Makertech3D/AXIS/README.md

# AXIS
Files and downloadable content relating to the Axis 3D Printer.

Build manuals can be found [here.](https://makertech-3d.dozuki.com/c/AXIS_3D_Printer)
