Makertech3D/AXIS/Linear Rail Upgrade/README.md

# AXIS Linear Rail Upgrade

The Linear Rail Upgrade is unfortunately no longer available for sale. However you can self source the components for one with the BOM and STL. files (for the 3D printed parts) in this repo.

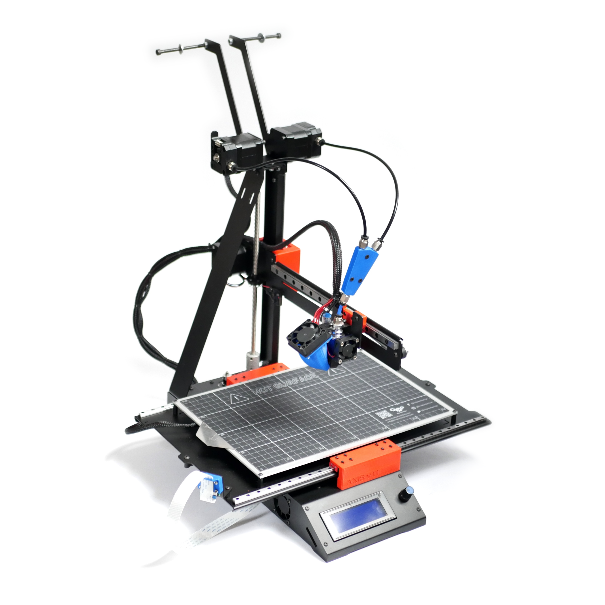
[picture p1: Linear Rail Upgrade/LRU Image.png]
