Makertech3D/AXIS/Linear Rail Upgrade/LRU BOM.xlsx

Part | Notes | Qty
MGN7 Rail - 400mm |  | 2
MGN7-H Block |  | 4
MGN9 Rail - 270mm |  | 1
MGN-9 Block |  | 1
MGN15 Rail - 270mm |  | 1
MGN-H Block |  | 1
Metal Coupling 5mmx8mm |  | 1
M4 Threaded Insert |  | 11
3D Printed Parts | https://github.com/Makertech3D/AXIS/tree/master/Linear%20Rail%20Upgrade
Fastener Pack
M2 x 10mm Cap | Rails to base | 6
M2 Nyloc Nut | Rails to base | 6
M2 x 6mm Cap | Base rails to bracket | 16
M3 x 12mm Cap | Rail to gantry and pillar | 6
M3 Nyloc Nut | Rail to gantry and pillar | 6
M3 x 6mm Button | Tool carraige to rail | 4
M3 x 8mm Cap | Gantry to Z-carriage | 4
M3 x 35mm Slot | Tool carraige belt hooks | 2
M4 x 6mm Button | Bracket mounting | 11
M3 x 15mm standoff | Heated Bed | 4
