Makertech3D/AXIS/Axis 3D Printed Parts/Axis Splitter v2_Back.STL

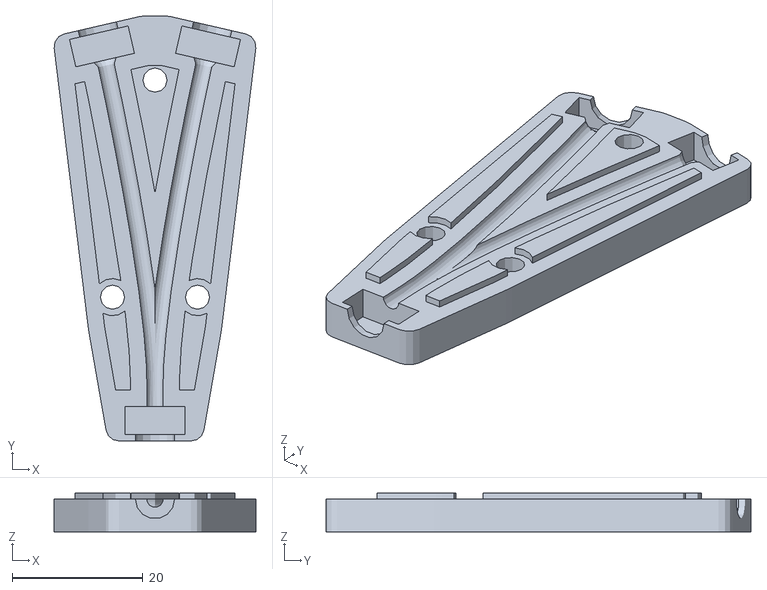
[picture p2: CAD file, 2020-10-02]
Axis 3D Printed Parts/Axis Splitter v2_Back.STL
30.8 x 65.0 x 5.90
