Makertech3D/AXIS/Axis Metal Parts/AXIS Base.STEP

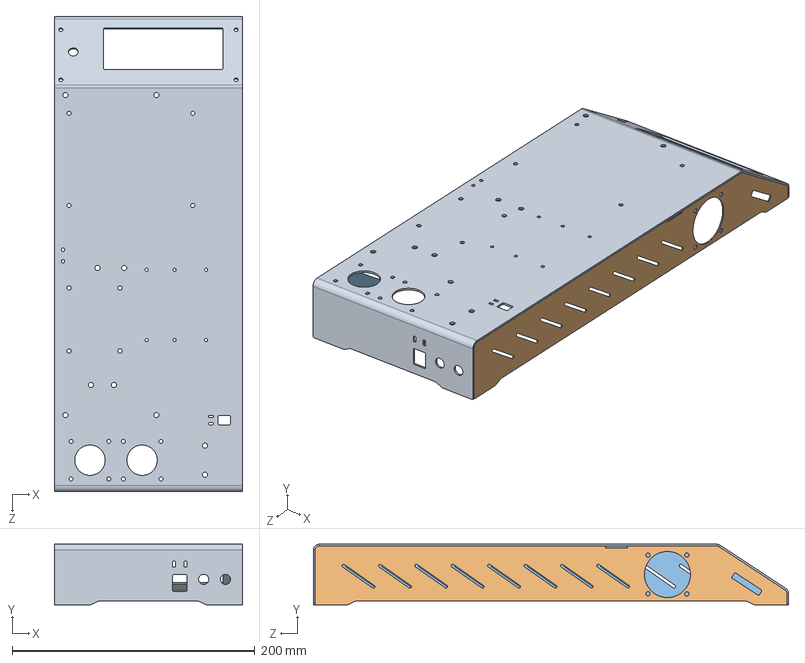
[picture p3: CAD file, 2020-06-16]
Axis Metal Parts/AXIS Base.STEP
155.0 x 50.0 x 392.0 mm
AXIS Base
AXIS Left Panel
AXIS Right Panel
