Makertech3D/AXIS/Linear Guides/Linear Guide Fixed.STEP

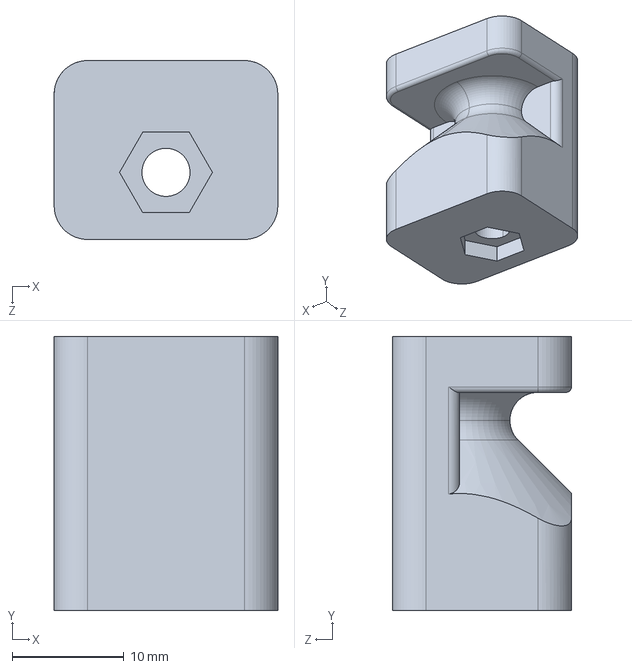
[picture p4: CAD file, 2020-08-13]
Linear Guides/Linear Guide Fixed.STEP
20.0 x 24.5 x 16.0 mm
