Makertech3D/AXIS/Linear Rail Upgrade/LRU_Z^AXIS v1.1.STL

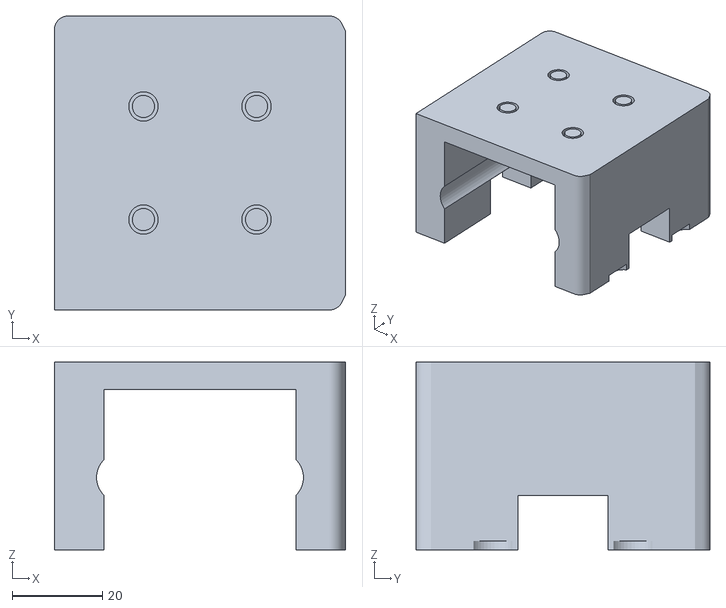
[picture p5: CAD file, 2022-01-27]
Linear Rail Upgrade/LRU_Z^AXIS v1.1.STL
64.4 x 65.0 x 41.5
