Makertech3D/AXIS/Axis Metal Parts/AXIS Z-Pillar_A.STEP

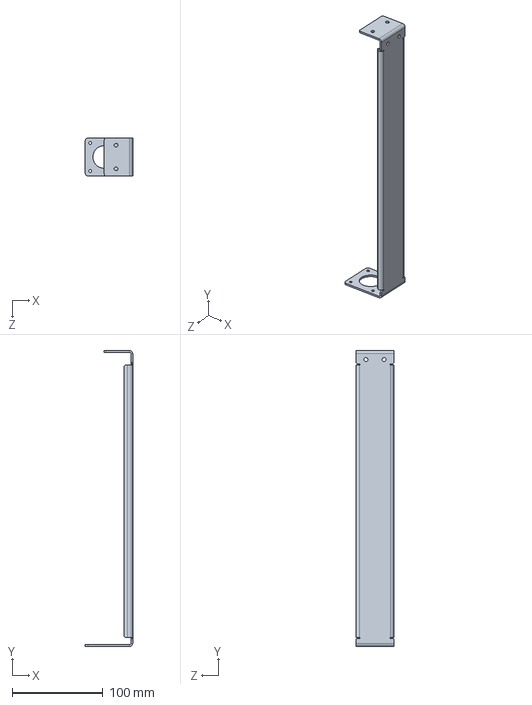
[picture p7: CAD file, 2020-06-16]
Axis Metal Parts/AXIS Z-Pillar_A.STEP
52.5 x 327.0 x 42.0 mm
