Makertech3D/AXIS/Linear Guides/Linear Guide Eccentric.STEP

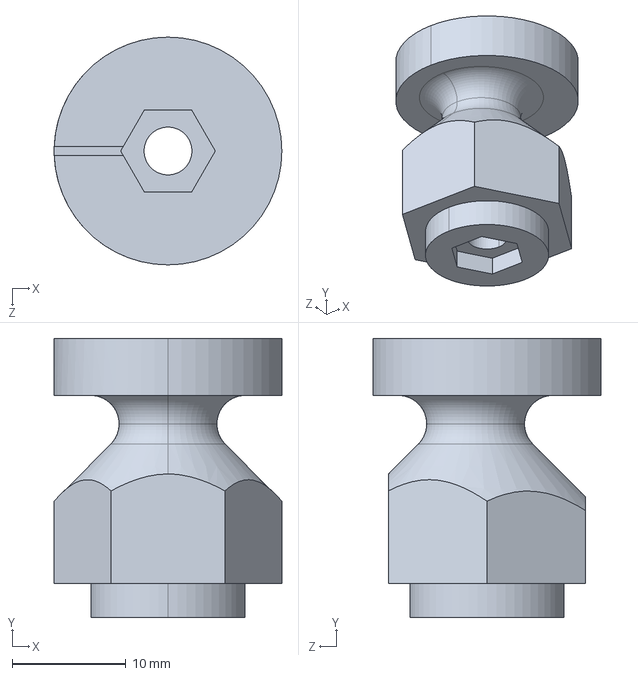
[picture p8: CAD file, 2020-08-13]
Linear Guides/Linear Guide Eccentric.STEP
20.0 x 24.5 x 20.0 mm
