Makertech3D/AXIS/Linear Rail Upgrade/LRU_Y^AXIS v1.1.STL

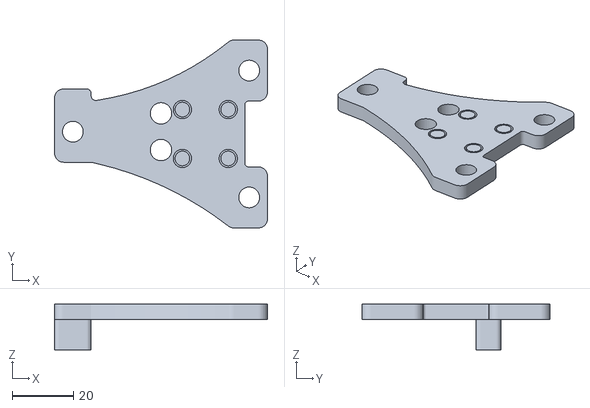
[picture p9: CAD file, 2022-01-27]
Linear Rail Upgrade/LRU_Y^AXIS v1.1.STL
69.7 x 61.5 x 15.0
