Makertech3D/AXIS/Axis 3D Printed Parts/Extruder motor holder (no spool).stl

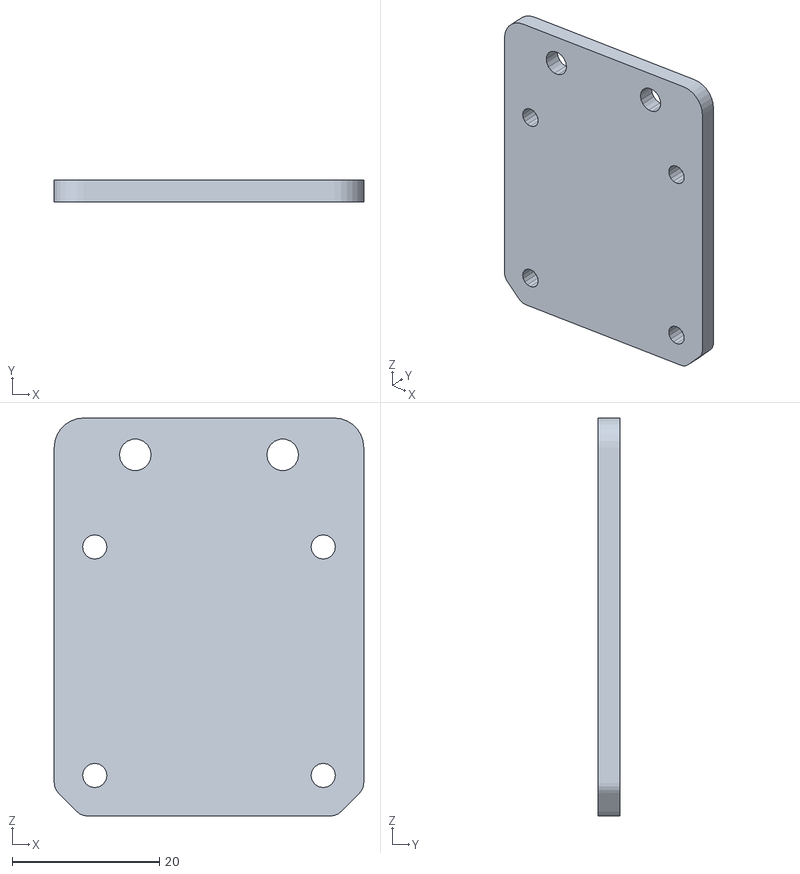
[picture p10: CAD file, 2020-08-17]
Axis 3D Printed Parts/Extruder motor holder (no spool).stl
42.0 x 3.00 x 54.0
