Makertech3D/AXIS/Linear Rail Upgrade/LRU_X-Rear^AXIS v1.1.STL

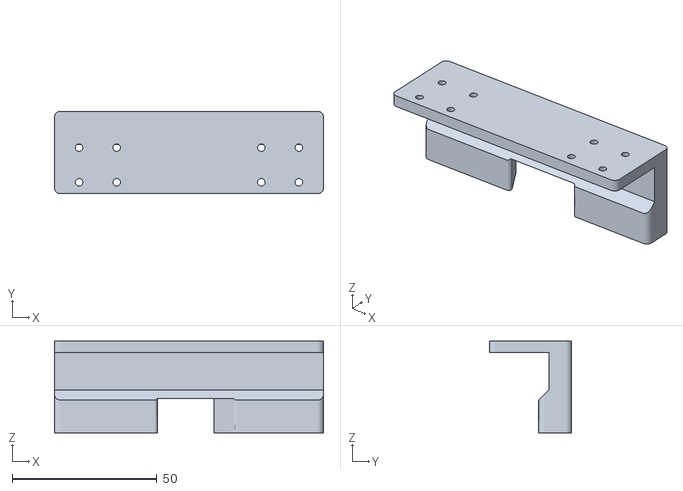
[picture p11: CAD file, 2022-01-27]
Linear Rail Upgrade/LRU_X-Rear^AXIS v1.1.STL
93.0 x 28.5 x 31.8
