Makertech3D/AXIS/Axis 3D Printed Parts/AXIS 40mm Fan Shroud.STL

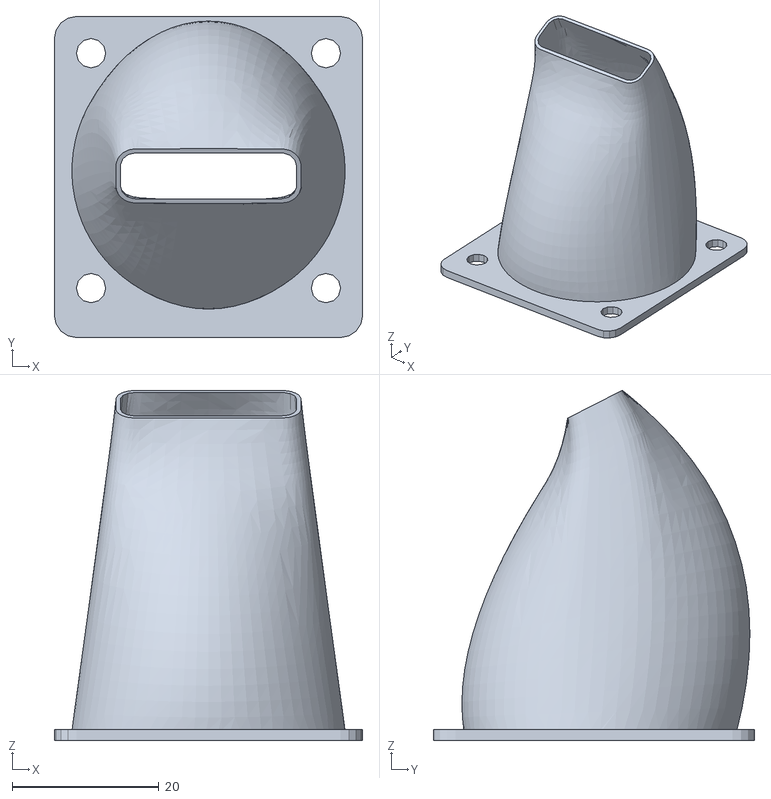
[picture p12: CAD file, 2020-08-03]
Axis 3D Printed Parts/AXIS 40mm Fan Shroud.STL
42.0 x 43.7 x 47.7
