Makertech3D/AXIS/Axis Metal Parts/AXIS Platform.STEP

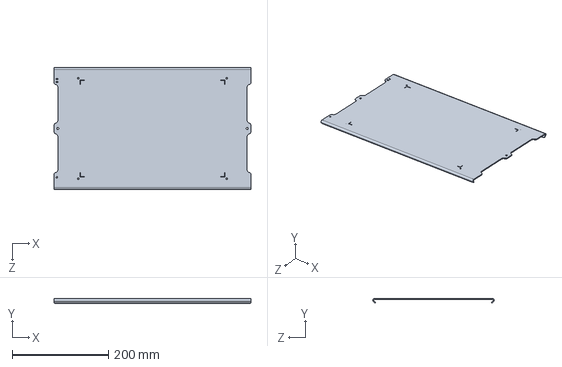
[picture p13: CAD file, 2020-06-16]
Axis Metal Parts/AXIS Platform.STEP
410.0 x 9.90 x 253.1 mm
