Makertech3D/AXIS/Linear Rail Upgrade/LRU_X-Front^AXIS v1.1.STL

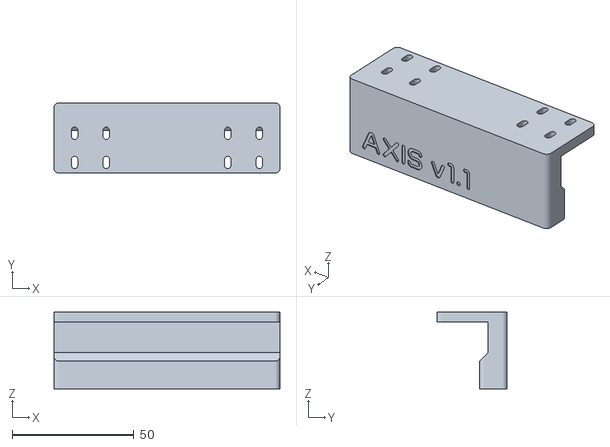
[picture p14: CAD file, 2022-01-27]
Linear Rail Upgrade/LRU_X-Front^AXIS v1.1.STL
93.0 x 29.0 x 31.5
