Makertech3D/AXIS/Axis 3D Printed Parts/Pi Cam 3D Printed Cover.STL

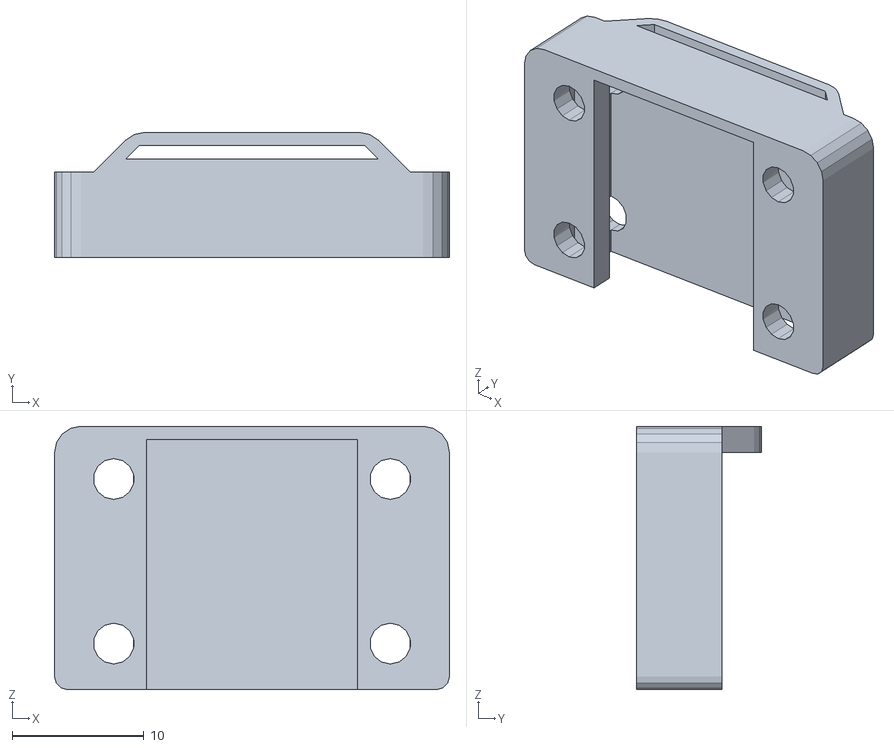
[picture p15: CAD file, 2020-08-03]
Axis 3D Printed Parts/Pi Cam 3D Printed Cover.STL
30.0 x 9.50 x 20.0
