Makertech3D/AXIS/Axis Metal Parts/AXIS Z-Pillar_B.STEP

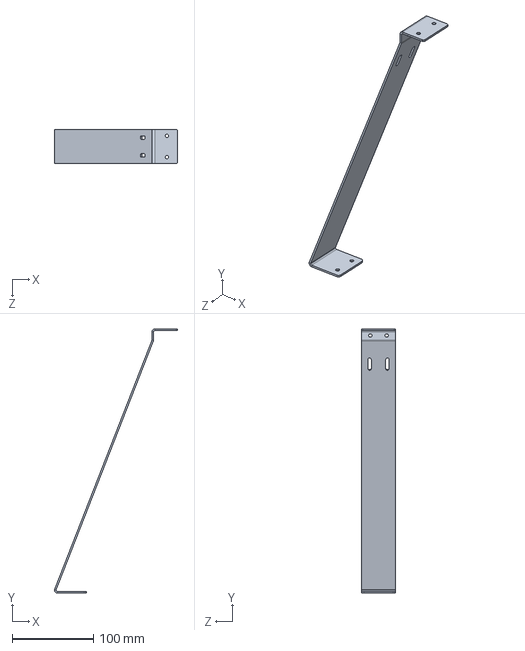
[picture p16: CAD file, 2020-06-16]
Axis Metal Parts/AXIS Z-Pillar_B.STEP
151.5 x 325.0 x 42.0 mm
