Makertech3D/AXIS/Axis Metal Parts/AXIS Spool Holder.STEP

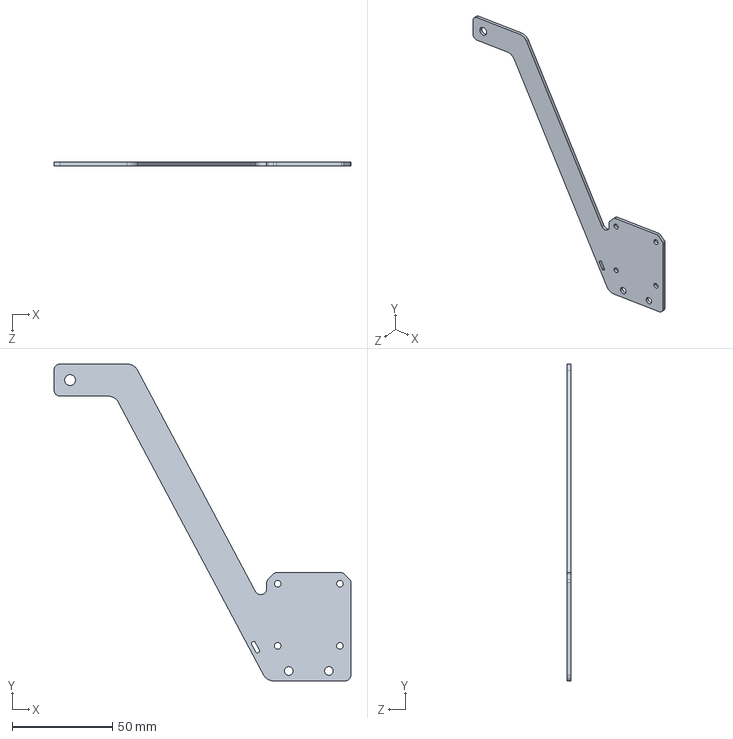
[picture p17: CAD file, 2020-06-16]
Axis Metal Parts/AXIS Spool Holder.STEP
148.0 x 158.0 x 2.00 mm
