Makertech3D/AXIS/Axis Metal Parts/AXIS Tool Carriage.STEP

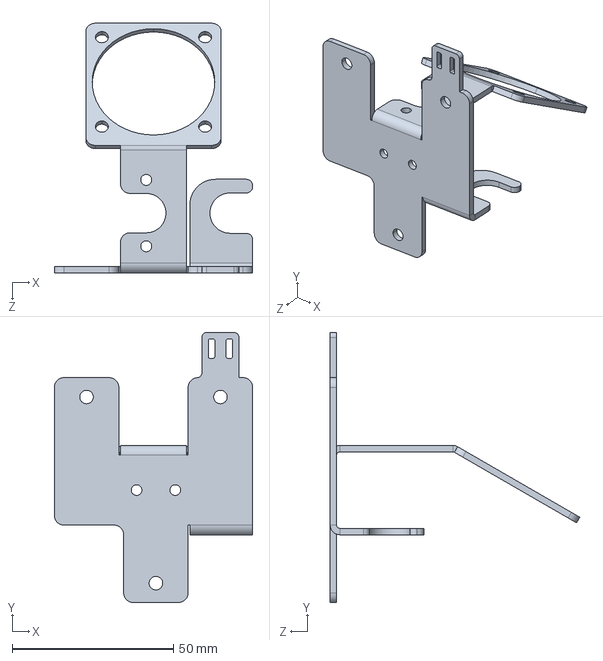
[picture p18: CAD file, 2020-06-16]
Axis Metal Parts/AXIS Tool Carriage.STEP
61.5 x 83.7 x 77.4 mm
