Makertech3D/AXIS/Axis Metal Parts/AXIS Pi Cam Case.STEP

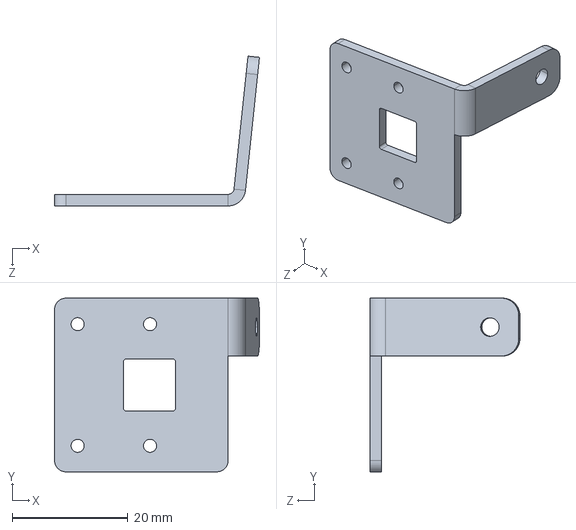
[picture p19: CAD file, 2020-06-16]
Axis Metal Parts/AXIS Pi Cam Case.STEP
35.4 x 30.0 x 25.9 mm
