Makertech3D/AXIS/Axis Metal Parts/AXIS Gantry.STEP

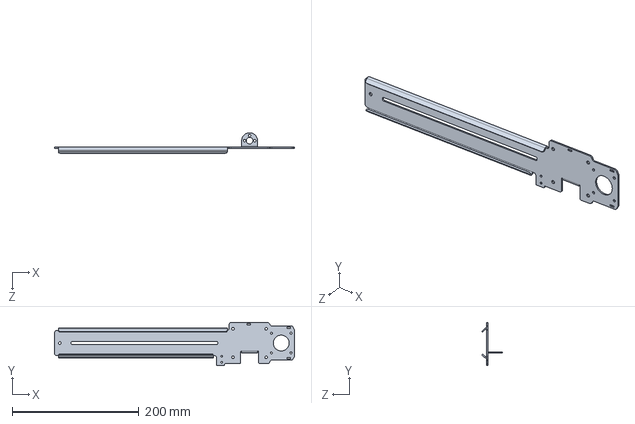
[picture p20: CAD file, 2020-06-16]
Axis Metal Parts/AXIS Gantry.STEP
379.2 x 68.0 x 32.4 mm
