Makertech3D/AXIS/(list of files, cad)

Other CAD files:
Axis Metal Parts/AXIS Lead Screw Bracket.STEP
Linear Guides/Linear Guide Eccentric.STL
Linear Guides/Linear Guide Fixed.STL
