Makertech3D/AXIS/(threads)

Thread 2 (2020-08-13):

STL/Step Files For Blower Fan Part Cooling Setup

mikejr83, 2020-08-13:
In the original Kickstarter video the part cooling fan looked like a 5015 blower fan. Is it possible that these files could be added as well? I'm not exactly thrilled with the current part cooling setup. I assume it was dropped because of additional costs.
