Makertech3D/AXIS/Axis Metal Parts/AXIS Base.PDF

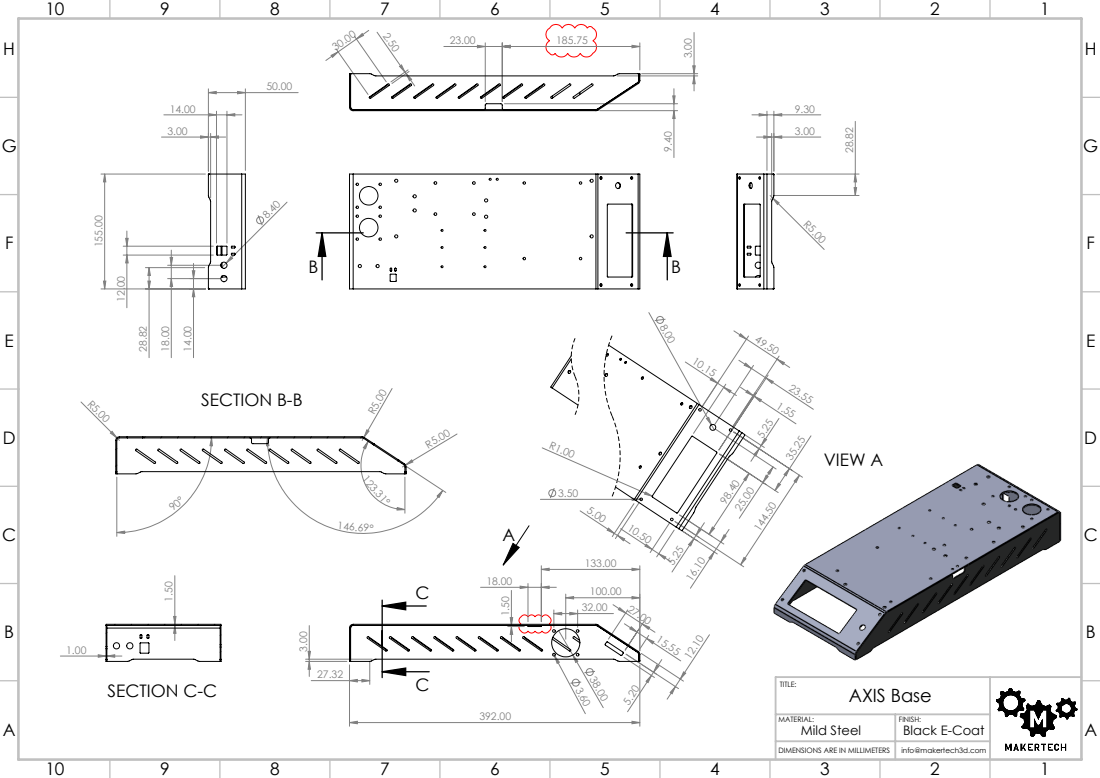
[picture p21: page 1]
VIEW A; SECTION C-C; SECTION B-B; Mild Steel

TITLE: AXIS Base

MATERIAL: | FINISH: Black E-Coat

DIMENSIONS ARE IN MILLIMETERS | info@makertech3d.com

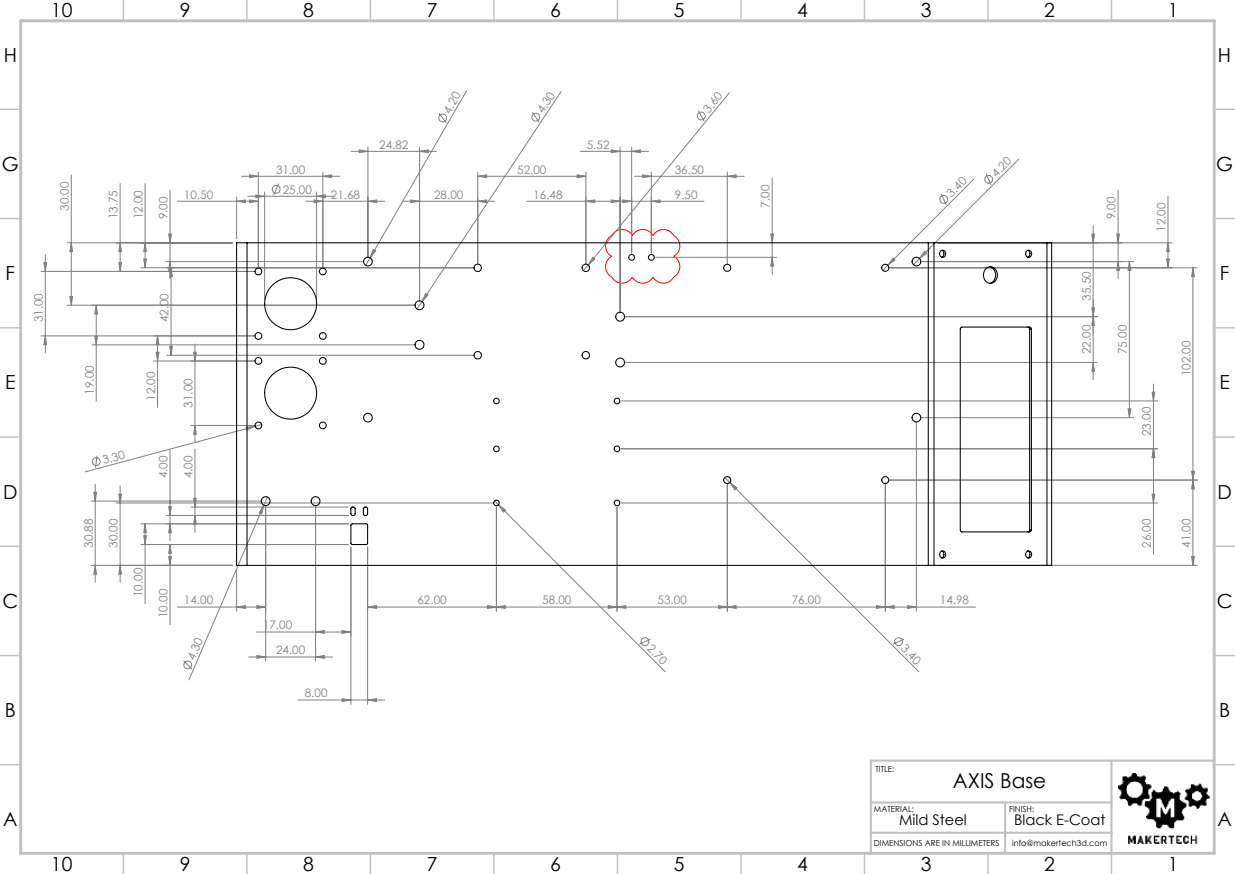
[picture p22: page 2]
Mild Steel

TITLE: AXIS Base

MATERIAL: | FINISH: Black E-Coat

DIMENSIONS ARE IN MILLIMETERS | info@makertech3d.com
