Makertech3D/AXIS/Axis Metal Parts/AXIS Gantry.PDF

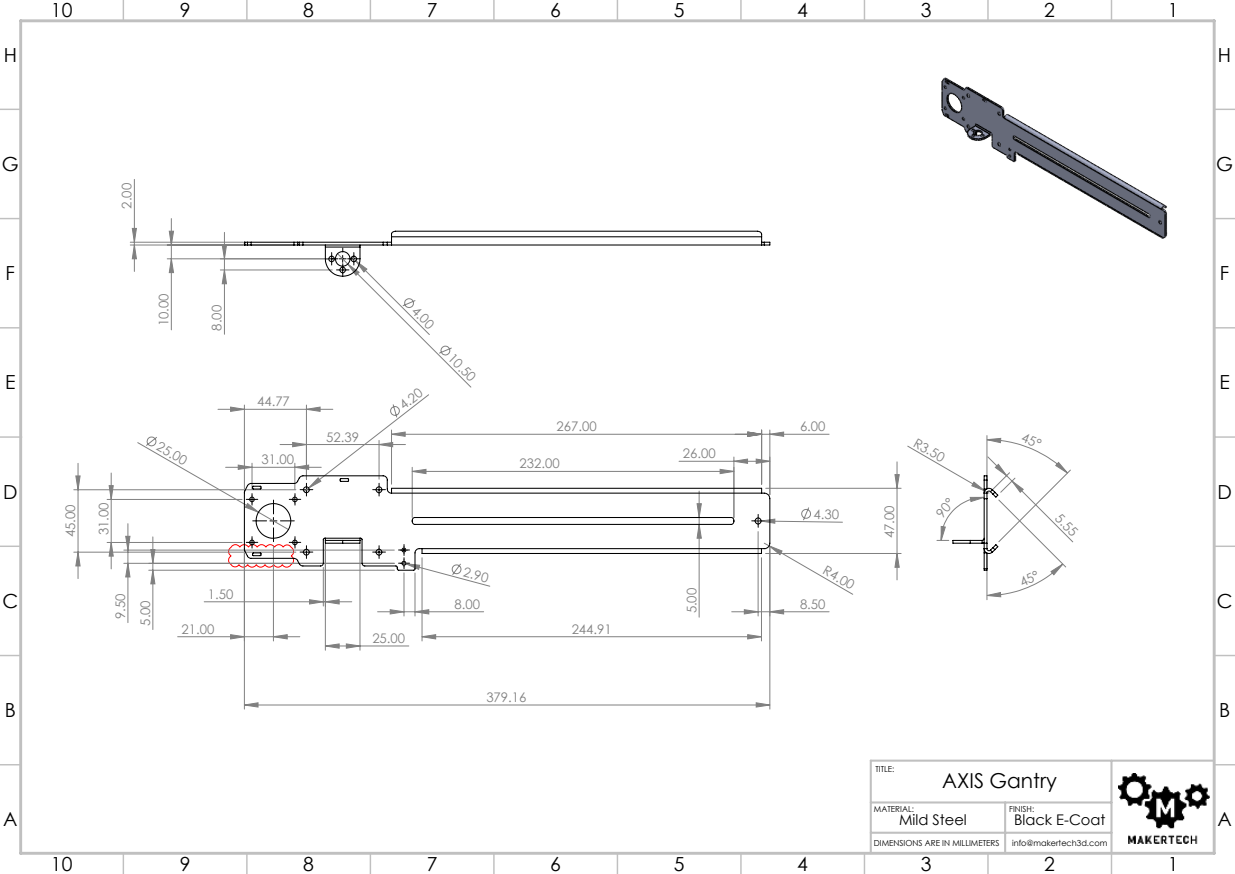
[picture p23: page 1]
Mild Steel

TITLE: AXIS Gantry

MATERIAL: | FINISH: Black E-Coat

DIMENSIONS ARE IN MILLIMETERS | info@makertech3d.com
