Makertech3D/AXIS/Axis Metal Parts/AXIS Lead Screw Bracket.PDF

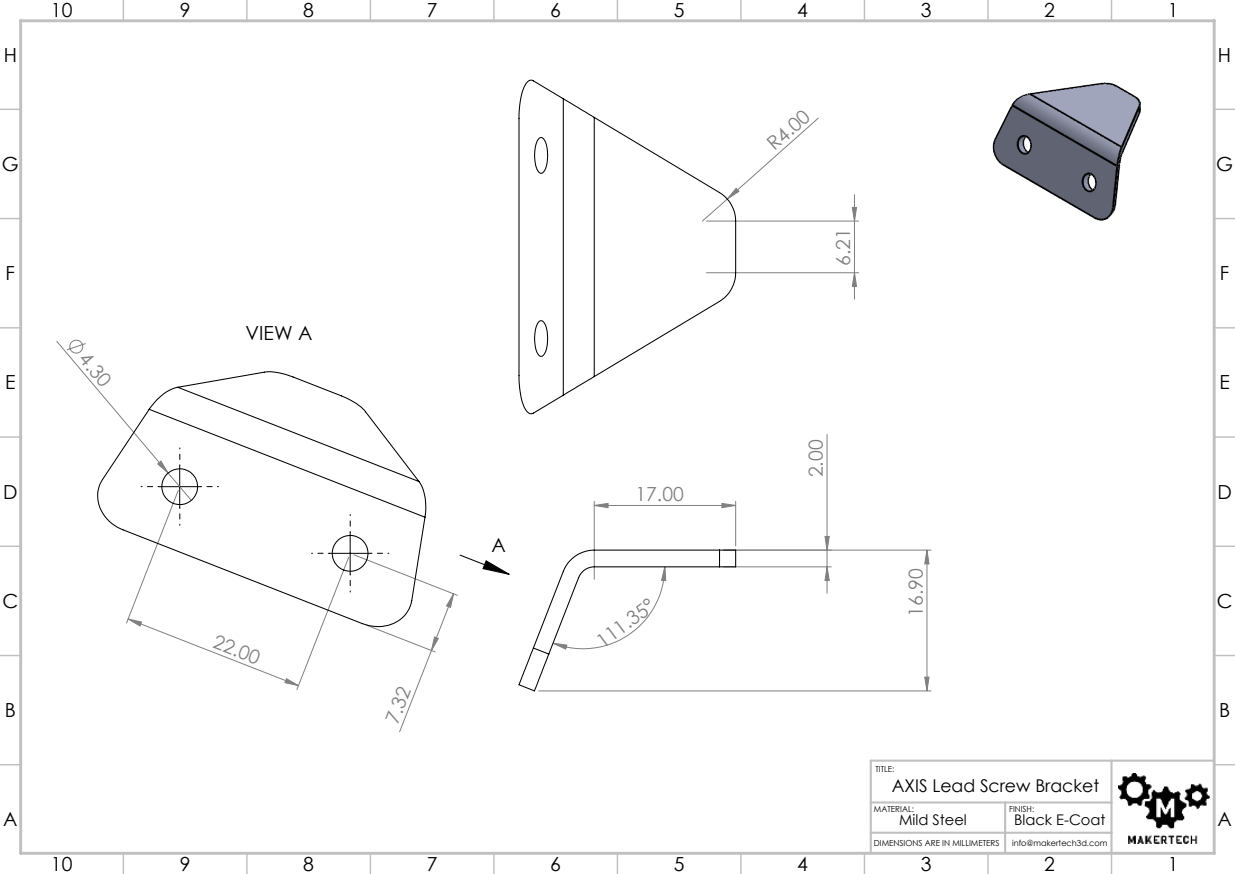
[picture p24: page 1]
VIEW A; Mild Steel

TITLE: AXIS Lead Screw Bracket

MATERIAL: | FINISH: Black E-Coat

DIMENSIONS ARE IN MILLIMETERS | info@makertech3d.com
