Makertech3D/AXIS/Axis Metal Parts/AXIS Pi Cam Case.PDF

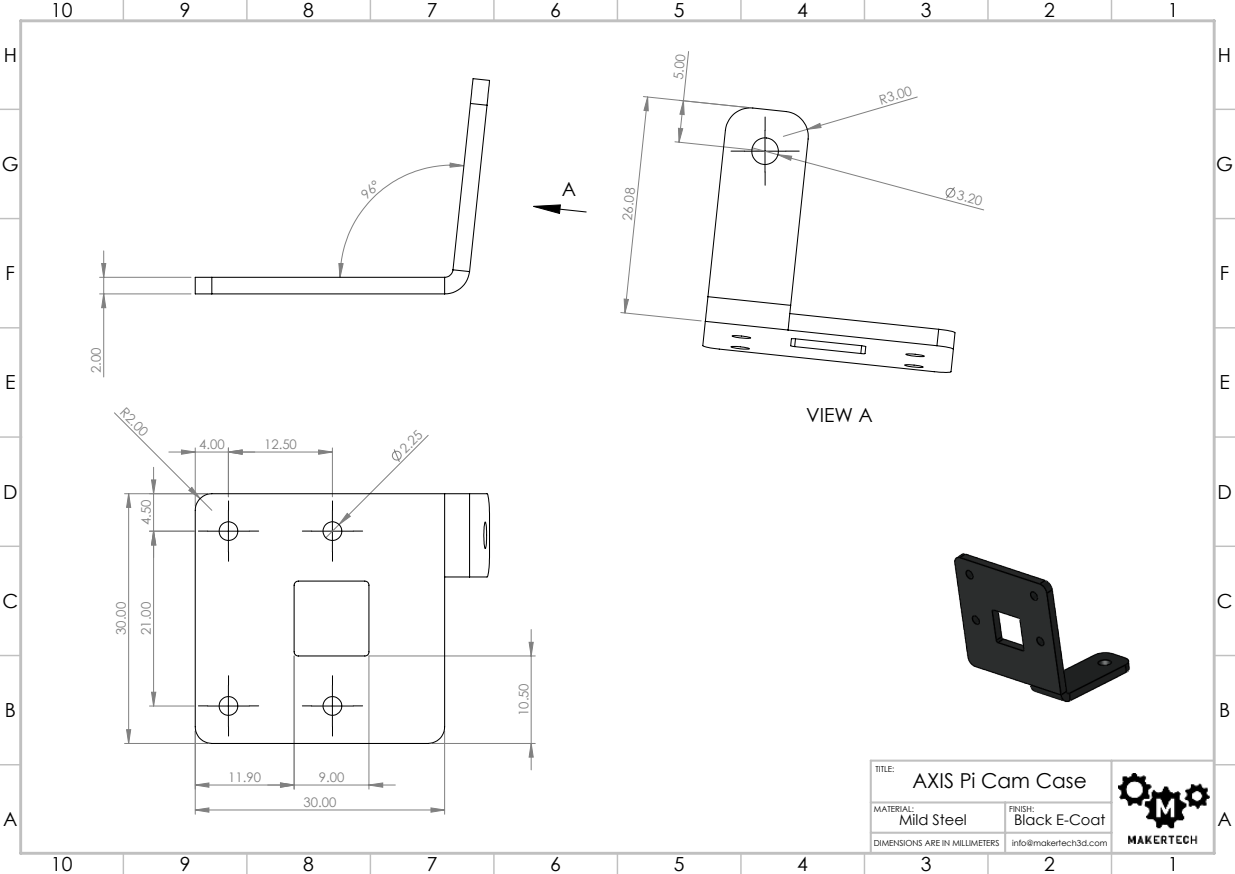
[picture p25: page 1]
VIEW A; Mild Steel

TITLE: AXIS Pi Cam Case

MATERIAL: | FINISH: Black E-Coat

DIMENSIONS ARE IN MILLIMETERS | info@makertech3d.com
