Makertech3D/AXIS/Axis Metal Parts/AXIS Platform.PDF

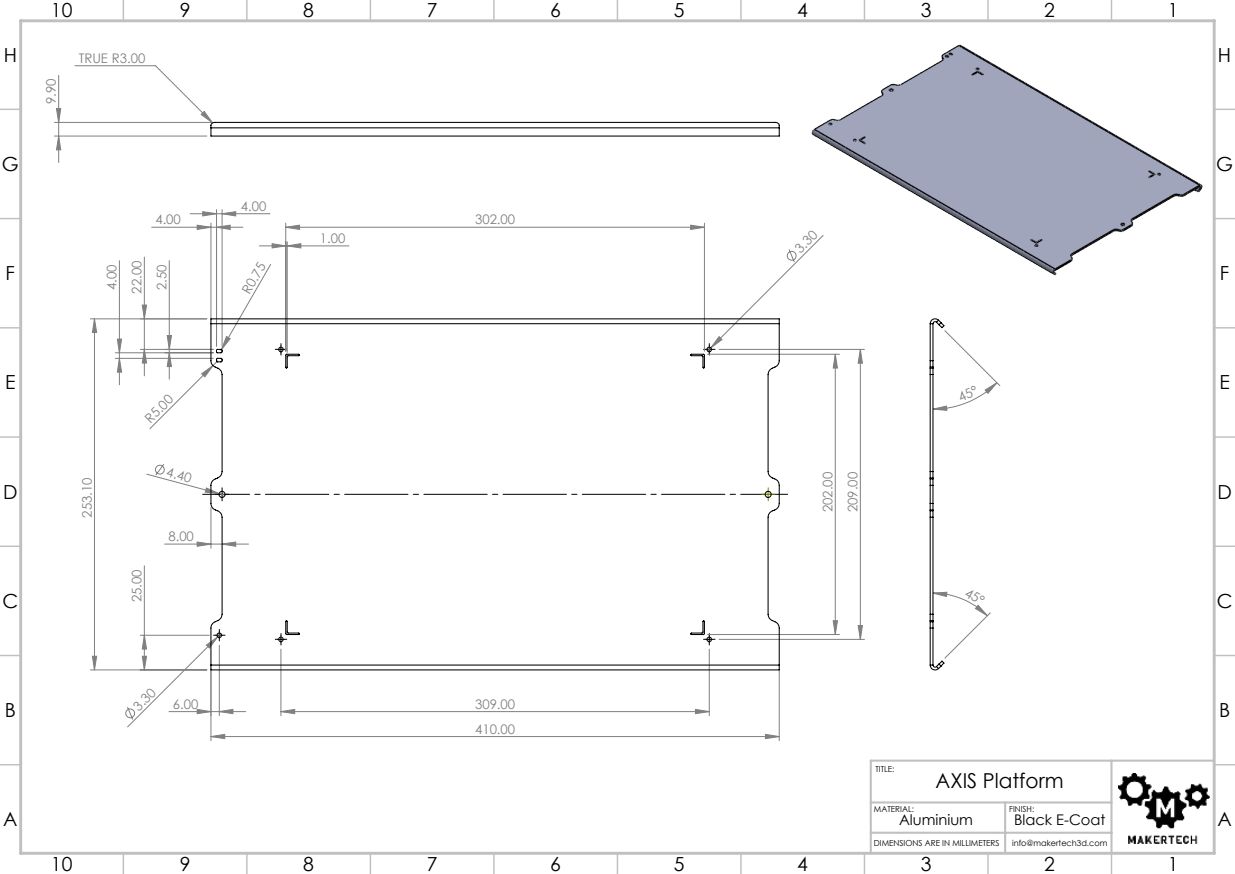
[picture p26: page 1]
TRUE R3.00

TITLE: AXIS Platform

MATERIAL: | FINISH: Black E-Coat

DIMENSIONS ARE IN MILLIMETERS | info@makertech3d.com
