Makertech3D/AXIS/Axis Metal Parts/AXIS Spool Holder.PDF

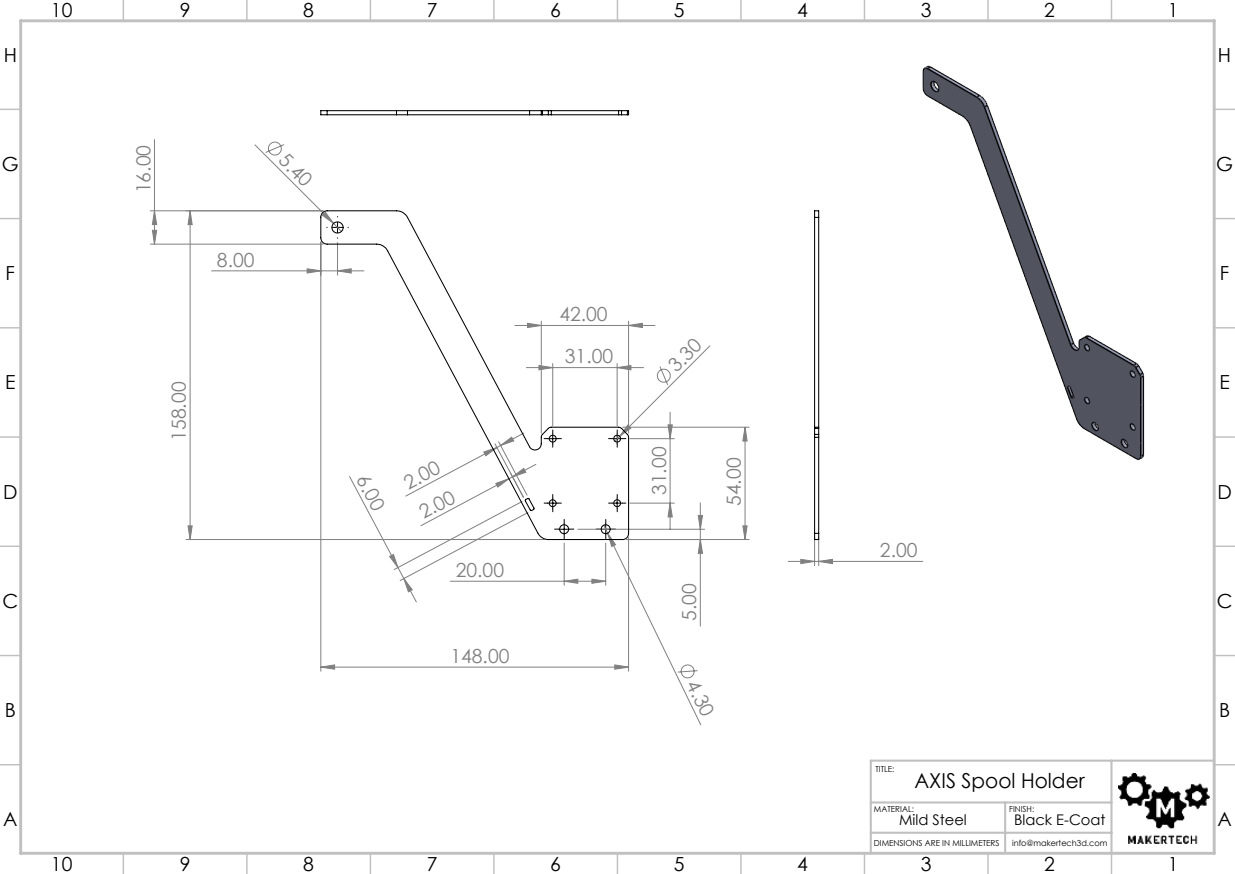
[picture p27: page 1]
Mild Steel

TITLE: AXIS Spool Holder

MATERIAL: | FINISH: Black E-Coat

DIMENSIONS ARE IN MILLIMETERS | info@makertech3d.com
