Makertech3D/AXIS/Axis Metal Parts/AXIS Tool Carriage.PDF

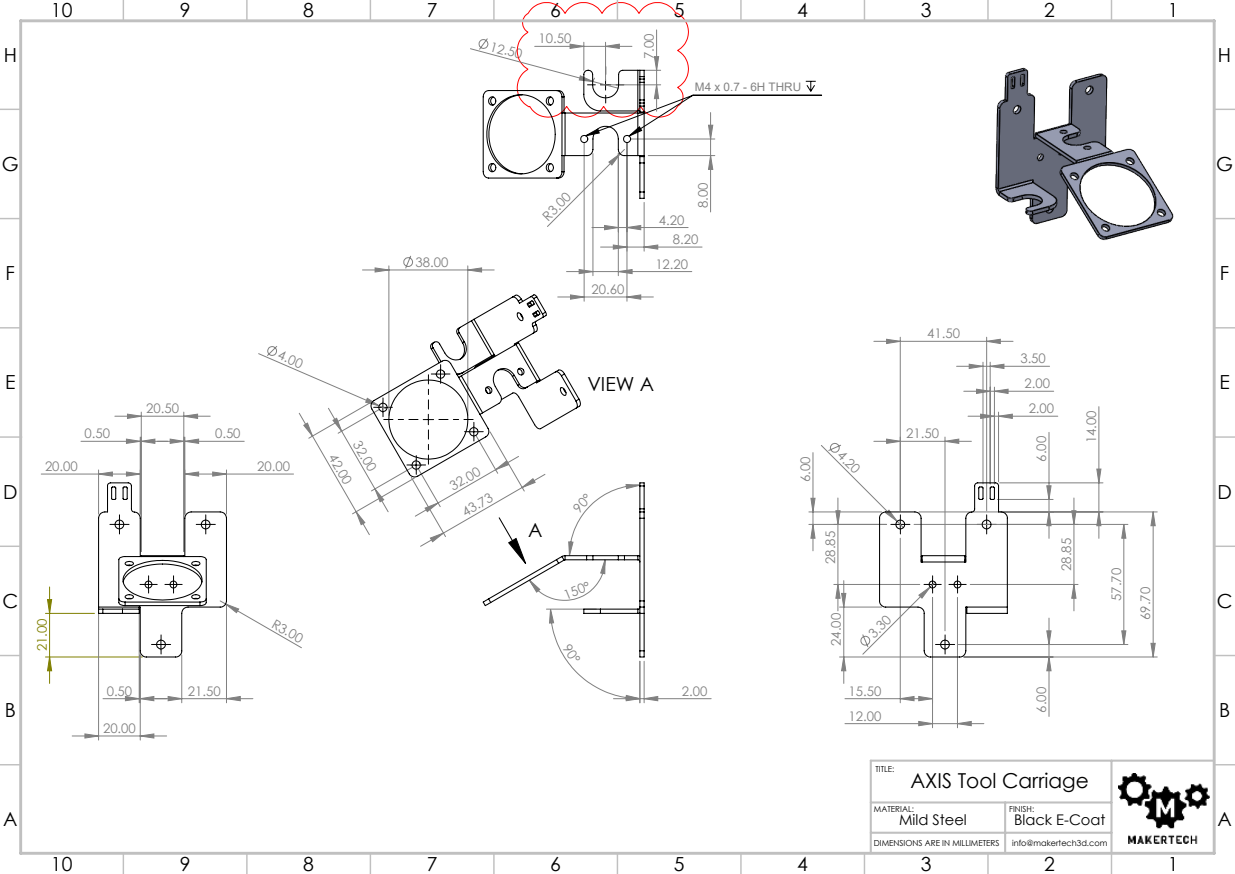
[picture p28: page 1]
M4 x 0.7 - 6H THRU; VIEW A; Mild Steel

TITLE: AXIS Tool Carriage

MATERIAL: | FINISH: Black E-Coat

DIMENSIONS ARE IN MILLIMETERS | info@makertech3d.com
