Makertech3D/AXIS/Axis Metal Parts/AXIS Z-Pillar_B.PDF

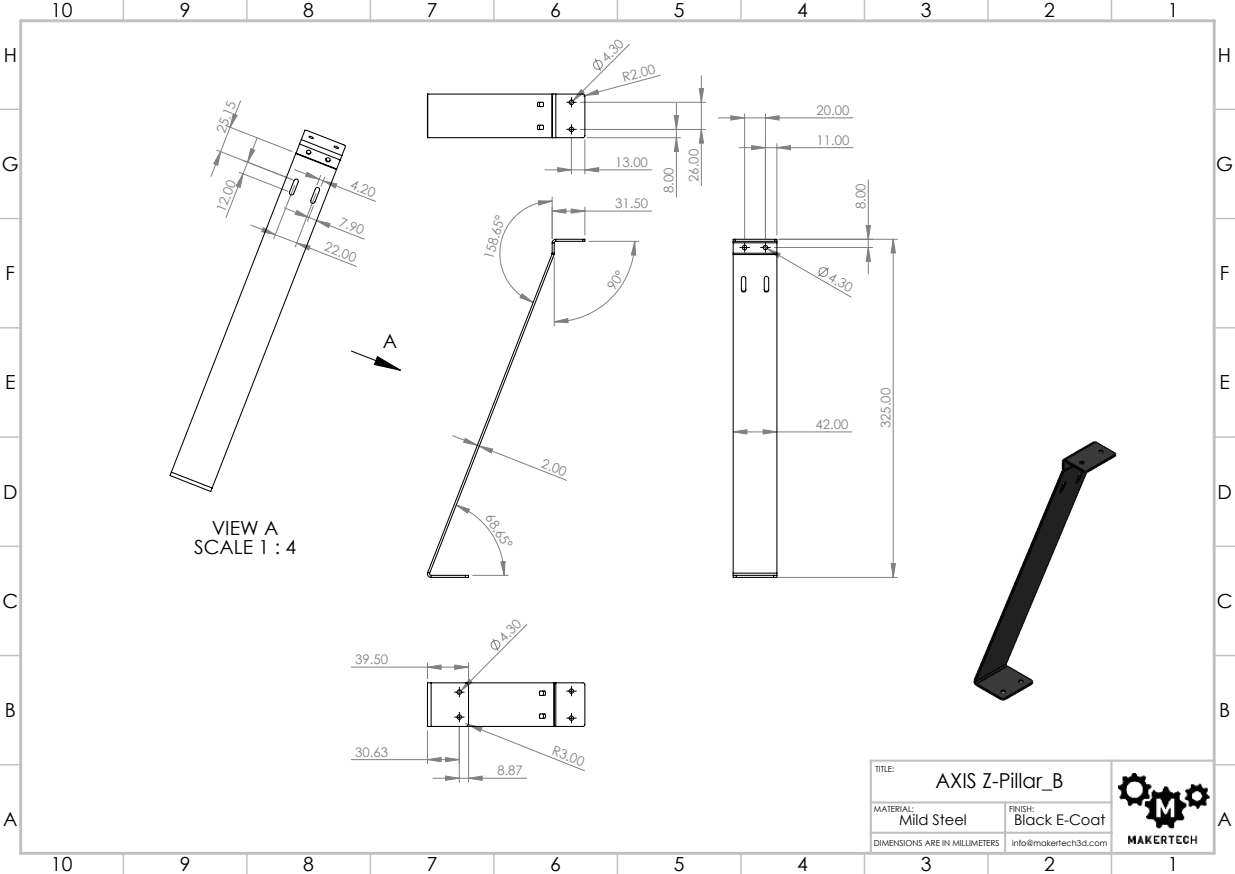
[picture p30: page 1]
VIEW A SCALE 1 : 4; Mild Steel

TITLE: AXIS Z-Pillar_B

MATERIAL: | FINISH: Black E-Coat

DIMENSIONS ARE IN MILLIMETERS | info@makertech3d.com
