Makertech3D/AXIS/Axis Marlin Firmware/Marlin/Configuration.h

#pragma once
#define CONFIGURATION_H_VERSION 020005
#define STRING_CONFIG_H_AUTHOR "(none, default config)" // Who made the changes.
#define SHOW_BOOTSCREEN
#define SERIAL_PORT 0
#define BAUDRATE 250000
  #define MOTHERBOARD BOARD_MKS_GEN_L_V2
#define CUSTOM_MACHINE_NAME "AXIS"
#define EXTRUDERS 2
#define DEFAULT_NOMINAL_FILAMENT_DIA 1.75
#define SINGLENOZZLE
#define TEMP_SENSOR_0 11
#define TEMP_SENSOR_1 0
#define TEMP_SENSOR_2 0
#define TEMP_SENSOR_3 0
#define TEMP_SENSOR_4 0
#define TEMP_SENSOR_5 0
#define TEMP_SENSOR_6 0
#define TEMP_SENSOR_7 0
#define TEMP_SENSOR_BED 0
#define TEMP_SENSOR_PROBE 0
#define TEMP_SENSOR_CHAMBER 0
#define DUMMY_THERMISTOR_998_VALUE 25
#define DUMMY_THERMISTOR_999_VALUE 100
#define MAX_REDUNDANT_TEMP_SENSOR_DIFF 10
#define TEMP_RESIDENCY_TIME     10  // (seconds) Time to wait for hotend to "settle" in M109
#define TEMP_WINDOW              1  // (°C) Temperature proximity for the "temperature reached" timer
#define TEMP_HYSTERESIS          3  // (°C) Temperature proximity considered "close enough" to the target
#define TEMP_BED_RESIDENCY_TIME 10  // (seconds) Time to wait for bed to "settle" in M190
#define TEMP_BED_WINDOW          1  // (°C) Temperature proximity for the "temperature reached" timer
#define TEMP_BED_HYSTERESIS      3  // (°C) Temperature proximity considered "close enough" to the target
#define HEATER_0_MINTEMP   5
#define HEATER_1_MINTEMP   5
#define HEATER_2_MINTEMP   5
#define HEATER_3_MINTEMP   5
#define HEATER_4_MINTEMP   5
#define HEATER_5_MINTEMP   5
#define HEATER_6_MINTEMP   5
#define HEATER_7_MINTEMP   5
#define BED_MINTEMP        5
#define HEATER_0_MAXTEMP 270
#define HEATER_1_MAXTEMP 275
#define HEATER_2_MAXTEMP 275
#define HEATER_3_MAXTEMP 275
#define HEATER_4_MAXTEMP 275
#define HEATER_5_MAXTEMP 275
#define HEATER_6_MAXTEMP 275
#define HEATER_7_MAXTEMP 275
#define BED_MAXTEMP      70
#define HEATER_BED_PIN            RAMPS_D8_PIN
#define PIDTEMP
#define BANG_MAX 255     // Limits current to nozzle while in bang-bang mode; 255=full current
#define PID_MAX BANG_MAX // Limits current to nozzle while PID is active (see PID_FUNCTIONAL_RANGE below); 255=full current
#define PID_K1 0.95      // Smoothing factor within any PID loop
  #define PID_FUNCTIONAL_RANGE 10 // If the temperature difference between the target temperature and the actual temperature
  #define DEFAULT_Kp 22.2
  #define DEFAULT_Ki 1.08
  #define DEFAULT_Kd 114
#define MAX_BED_POWER 255 // limits duty cycle to bed; 255=full current
#define PREVENT_COLD_EXTRUSION
#define EXTRUDE_MINTEMP 170
#define PREVENT_LENGTHY_EXTRUDE
#define EXTRUDE_MAXLENGTH 200
#define THERMAL_PROTECTION_HOTENDS // Enable thermal protection for all extruders
#define THERMAL_PROTECTION_BED     // Enable thermal protection for the heated bed
#define THERMAL_PROTECTION_CHAMBER // Enable thermal protection for the heated chamber
#define USE_ZMIN_PLUG
#define USE_XMAX_PLUG
#define USE_YMAX_PLUG
#define ENDSTOPPULLUPS
#define X_MIN_ENDSTOP_INVERTING false // Set to true to invert the logic of the endstop.
#define Y_MIN_ENDSTOP_INVERTING false // Set to true to invert the logic of the endstop.
#define Z_MIN_ENDSTOP_INVERTING false // Set to true to invert the logic of the endstop.
#define X_MAX_ENDSTOP_INVERTING false // Set to true to invert the logic of the endstop.
#define Y_MAX_ENDSTOP_INVERTING false // Set to true to invert the logic of the endstop.
#define Z_MAX_ENDSTOP_INVERTING false // Set to true to invert the logic of the endstop.
#define Z_MIN_PROBE_ENDSTOP_INVERTING false // Set to true to invert the logic of the probe.
#define X_DRIVER_TYPE  A4988
#define Y_DRIVER_TYPE  A4988
#define Z_DRIVER_TYPE  A4988
#define E0_DRIVER_TYPE A4988
#define E1_DRIVER_TYPE A4988
#define DEFAULT_AXIS_STEPS_PER_UNIT   { 100, 100, 400, 85 }
#define DEFAULT_MAX_FEEDRATE          { 300, 300, 5, 200 }
#define DEFAULT_MAX_ACCELERATION      { 1000, 1000, 50, 10000 }
#define DEFAULT_ACCELERATION          500    // X, Y, Z and E acceleration for printing moves
#define DEFAULT_RETRACT_ACCELERATION  5000    // E acceleration for retracts
#define DEFAULT_TRAVEL_ACCELERATION   500    // X, Y, Z acceleration for travel (non printing) moves
#define DEFAULT_EJERK    10.0  // May be used by Linear Advance
  #define JUNCTION_DEVIATION_MM 0.013 // (mm) Distance from real junction edge
#define Z_MIN_PROBE_USES_Z_MIN_ENDSTOP_PIN
#define Z_MIN_PIN 32
#define FIX_MOUNTED_PROBE
#define NOZZLE_TO_PROBE_OFFSET { 0, 26, 0 }
#define MIN_PROBE_EDGE 10
#define XY_PROBE_SPEED 8000
#define Z_PROBE_SPEED_FAST HOMING_FEEDRATE_Z
#define Z_PROBE_SPEED_SLOW (Z_PROBE_SPEED_FAST / 2)
#define Z_CLEARANCE_DEPLOY_PROBE   10 // Z Clearance for Deploy/Stow
#define Z_CLEARANCE_BETWEEN_PROBES  5 // Z Clearance between probe points
#define Z_CLEARANCE_MULTI_PROBE     5 // Z Clearance between multiple probes
#define Z_PROBE_LOW_POINT          -3 // Farthest distance below the trigger-point to go before stopping
#define Z_PROBE_OFFSET_RANGE_MIN -20
#define Z_PROBE_OFFSET_RANGE_MAX 20
#define X_ENABLE_ON 0
#define Y_ENABLE_ON 0
#define Z_ENABLE_ON 0
#define E_ENABLE_ON 0 // For all extruders
#define DISABLE_X false
#define DISABLE_Y false
#define DISABLE_Z false
#define DISABLE_E false             // For all extruders
#define DISABLE_INACTIVE_EXTRUDER   // Keep only the active extruder enabled
#define INVERT_X_DIR false
#define INVERT_Y_DIR false
#define INVERT_Z_DIR true
#define INVERT_E0_DIR false
#define INVERT_E1_DIR false
#define INVERT_E2_DIR false
#define INVERT_E3_DIR false
#define INVERT_E4_DIR false
#define INVERT_E5_DIR false
#define INVERT_E6_DIR false
#define INVERT_E7_DIR false
#define X_HOME_DIR 1
#define Y_HOME_DIR 1
#define Z_HOME_DIR -1
#define X_BED_SIZE 300
#define Y_BED_SIZE 200
#define X_MIN_POS 0
#define Y_MIN_POS 0
#define Z_MIN_POS 0
#define X_MAX_POS X_BED_SIZE
#define Y_MAX_POS Y_BED_SIZE
#define Z_MAX_POS 200
#define MIN_SOFTWARE_ENDSTOPS
  #define MIN_SOFTWARE_ENDSTOP_X
  #define MIN_SOFTWARE_ENDSTOP_Y
#define MAX_SOFTWARE_ENDSTOPS
  #define MAX_SOFTWARE_ENDSTOP_X
  #define MAX_SOFTWARE_ENDSTOP_Y
  #define MAX_SOFTWARE_ENDSTOP_Z
#define AUTO_BED_LEVELING_BILINEAR
#define RESTORE_LEVELING_AFTER_G28
  #define ENABLE_LEVELING_FADE_HEIGHT
  #define SEGMENT_LEVELED_MOVES
  #define LEVELED_SEGMENT_LENGTH 5.0 // (mm) Length of all segments (except the last one)
  #define G26_MESH_VALIDATION
    #define MESH_TEST_NOZZLE_SIZE    0.4  // (mm) Diameter of primary nozzle.
    #define MESH_TEST_LAYER_HEIGHT   0.2  // (mm) Default layer height for the G26 Mesh Validation Tool.
    #define MESH_TEST_HOTEND_TEMP  205    // (°C) Default nozzle temperature for the G26 Mesh Validation Tool.
    #define MESH_TEST_BED_TEMP      60    // (°C) Default bed temperature for the G26 Mesh Validation Tool.
    #define G26_XY_FEEDRATE         20    // (mm/s) Feedrate for XY Moves for the G26 Mesh Validation Tool.
    #define G26_RETRACT_MULTIPLIER   1.5  // G26 Q (retraction) used by default between mesh test elements.
  #define GRID_MAX_POINTS_X 5
  #define GRID_MAX_POINTS_Y 4
#define Z_SAFE_HOMING
  #define Z_SAFE_HOMING_X_POINT ((X_BED_SIZE) / 2)    // X point for Z homing when homing all axes (G28).
  #define Z_SAFE_HOMING_Y_POINT ((Y_BED_SIZE) / 2)    // Y point for Z homing when homing all axes (G28).
#define HOMING_FEEDRATE_XY (50*60)
#define HOMING_FEEDRATE_Z  (4*60)
#define VALIDATE_HOMING_ENDSTOPS
#define EEPROM_SETTINGS     // Persistent storage with M500 and M501
#define EEPROM_CHITCHAT       // Give feedback on EEPROM commands. Disable to save PROGMEM.
#define EEPROM_BOOT_SILENT    // Keep M503 quiet and only give errors during first load
#define HOST_KEEPALIVE_FEATURE        // Disable this if your host doesn't like keepalive messages
#define DEFAULT_KEEPALIVE_INTERVAL 2  // Number of seconds between "busy" messages. Set with M113.
#define BUSY_WHILE_HEATING            // Some hosts require "busy" messages even during heating
#define PREHEAT_1_LABEL       "PLA"
#define PREHEAT_1_TEMP_HOTEND 200
#define PREHEAT_1_TEMP_BED     60
#define PREHEAT_1_FAN_SPEED     0 // Value from 0 to 255
#define PREHEAT_2_LABEL       "ABS"
#define PREHEAT_2_TEMP_HOTEND 240
#define PREHEAT_2_TEMP_BED    100
#define PREHEAT_2_FAN_SPEED     0 // Value from 0 to 255
#define NOZZLE_PARK_FEATURE
  #define NOZZLE_PARK_POINT { (X_MAX_POS - 10), (Y_MAX_POS - 10), 10 }
  #define NOZZLE_PARK_XY_FEEDRATE 100   // (mm/s) X and Y axes feedrate (also used for delta Z axis)
  #define NOZZLE_PARK_Z_FEEDRATE 5      // (mm/s) Z axis feedrate (not used for delta printers)
#define PRINTJOB_TIMER_AUTOSTART
#define LCD_LANGUAGE en
#define DISPLAY_CHARSET_HD44780 JAPANESE
#define LCD_INFO_SCREEN_STYLE 0
#define SDSUPPORT
#define REVERSE_ENCODER_DIRECTION
#define INDIVIDUAL_AXIS_HOMING_MENU
#define REPRAP_DISCOUNT_SMART_CONTROLLER
#define SOFT_PWM_SCALE 0
#define SERVO_DELAY { 300 }
