Makertech3D/AXIS/(commit log)

2020-06-18 Axis Marlin Firmware to Axis Repo
    [Configuration.h, Configuration_adv.h]
2020-06-18 Axis Configurations v1.0
    [Configuration.h, Configuration_adv.h]
2020-07-07 Benchy Test Print
2020-08-03 Dual prints
2020-08-03 Parts upload
    [AXIS 40mm Fan Shroud.STL, Pi Cam 3D Printed Cover.STL]
2020-08-13 Linear guides
    [Linear Guide Eccentric.STEP, Linear Guide Eccentric.STL, Linear Guide Fixed.STEP, Linear Guide Fixed.STL]
2020-08-14 extruder-motor-holder-stl: added extruder holder stl
    [Extruder motor holder (no spool).stl]
2020-08-25 Max temp limits update
    [Configuration.h]
2020-08-25 Probing range increase
    [Configuration.h]
2020-10-02 Extruder Steps Update
    Steps for extruder lowered for better quality printing.
    [Configuration.h]
2020-10-02 Axis Dual Extruder Splitter v2
    The new design reduces the likely hood of jamming and provides a straighter path for the filament. We've also removed the need for the short ptfe tubes.
    [Axis Splitter v2_Back.STL, Axis Splitter v2_Front.STL]
2021-03-22 Linear Rail Upgrade (BETA)
    First commit
    [LRU_X-Front.STL, LRU_X-Rear.STL, LRU_Y.STL, LRU_Z.STL]
2022-01-27 Updated LRU .STL Files.
    [LRU_X-Front.STL, LRU_X-Front^AXIS v1.1.STL, LRU_X-Rear.STL, LRU_X-Rear^AXIS v1.1.STL, LRU_Y.STL, LRU_Y^AXIS v1.1.STL, LRU_Z.STL, LRU_Z^AXIS v1.1.STL]
2022-10-09 BOM Update
    [LRU BOM.xlsx]
